zUrp-Astronomics/basilisk/9_Assets/README.md

# 9_Assets

**Date** : 2026-10-06
**Dernière révision** : 2026-10-06
**Statut** : actif — porte la fiche (`zurp.yml`) et l'affiche (`basilisk.webp`) lues par le site zUrp, et les images du README
**Référencé par** : `README.md` (images), `7_Docs/MANUEL.md` (§ Arborescence)

Les ressources pour l'extérieur, les images du `README.md` (`Basilisk-Board.png`, `Basilisk-Board-top.png`, `Basilisk-Board-bot.png`), et la vitrine lue par le site, la fiche `zurp.yml` et l'affiche `basilisk.webp`.
