zUrp-Astronomics/basilisk/0_Datasheets/README.md

Les datasheets des composants utilisés (PDF du fabricant, nom d'origine).
