zUrp-Astronomics/basilisk/1_Board/README.md

Les fichiers de fabrication de la carte, tels que les sort l'outil de CAO.
