zUrp-Astronomics/basilisk/3_3D-Models/README.md

Les fichiers prêts à imprimer, tirés de `2_Hardware/`.
