zUrp-Astronomics/basilisk/7_Docs/README.md

La documentation du projet ; le README racine reste la porte d'entrée.
