zUrp-Astronomics/basilisk/8_References/README.md

# 8_References

**Date** : 2026-10-06
**Dernière révision** : 2026-10-06
**Statut** : actif — documents de référence externes (normes, projets amont), qui restent à leurs auteurs ; la documentation d'interopérabilité des objectifs ira dans `7_Docs/`, pas ici
**Référencé par** : `7_Docs/MANUEL.md` (§ Arborescence, § Licence), `README.md` (§ Licences)

Ce que le projet consulte, pas ce qu'il produit.
