zUrp-Astronomics/basilisk/1_Board/Basilisk-v1.0_1-Schematics.png

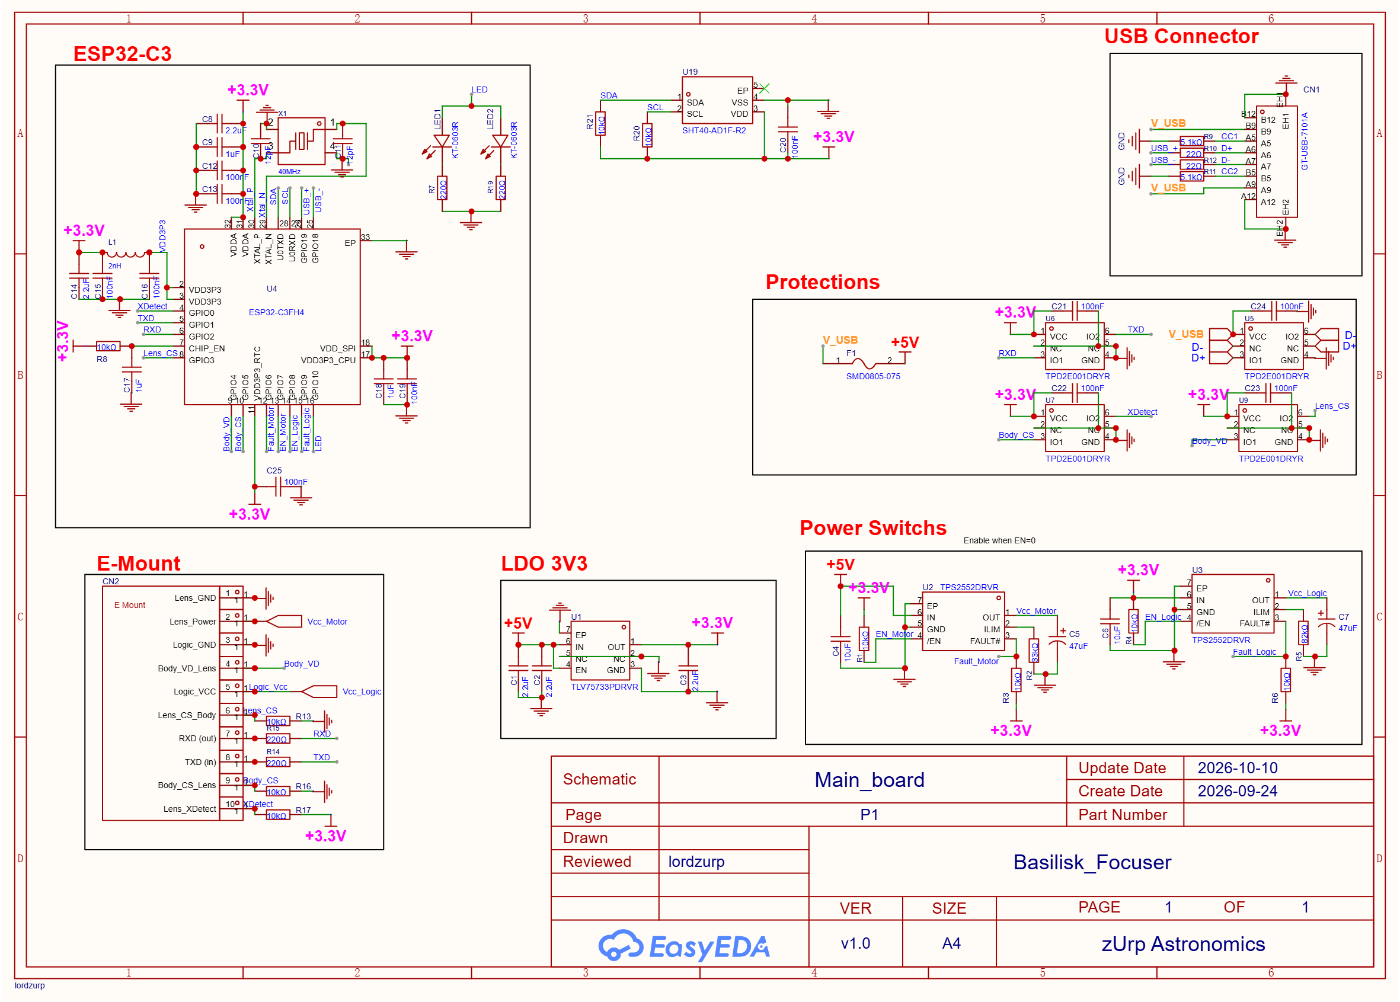
1_Board/Basilisk-v1.0_1-Schematics.png
