zUrp-Astronomics/basilisk/1_Board/Basilisk-v1.0_4-BoM.xlsx

No. | Quantity | Device | Designator | Footprint | Value | Manufacturer Part | Manufacturer | Supplier Part | Supplier | Add into BOM | Name | Category | JLCPCB Stock | JLCPCB Price | JLCPCB Part Class
1 | 5 | CL05A225MQ5NSNC | C1,C2,C3,C8,C14 | C0402 | 2.2uF | CL05A225MQ5NSNC | SAMSUNG(三星) | C12530 | LCSC | yes | 2.2uF | Capacitors:Multilayer Ceramic Capacitors MLCC - SMD/SMT | 4752852 | 0.0008 | Basic Part
2 | 2 | CL10A106KP8NNNC | C4,C6 | C0603 | 10uF | CL10A106KP8NNNC | SAMSUNG(三星) | C19702 | LCSC | yes | 10uF | Capacitors:Multilayer Ceramic Capacitors MLCC - SMD/SMT | 10417563 | 0.0046 | Basic Part
3 | 2 | T527I476M010ATE200 | C5,C7 | CAP-SMD_L3.2-W1.6 | 47uF | T527I476M010ATE200 | KEMET(基美) | C4951329 | LCSC | yes | 47uF | Capacitors:Tantalum Capacitors | 822 | 0.0738 | Extended Part
4 | 3 | CL05A105KA5NQNC | C9,C17,C18 | C0402 | 1uF | CL05A105KA5NQNC | SAMSUNG(三星) | C52923 | LCSC | yes | 1uF | Capacitors:Multilayer Ceramic Capacitors MLCC - SMD/SMT | 7267712 | 0.0014 | Basic Part
5 | 2 | 0402CG120J500NT | C10,C11 | C0402 | 12pF | 0402CG120J500NT | FH(风华) | C1547 | LCSC | yes | 12pF | Capacitors:Multilayer Ceramic Capacitors MLCC - SMD/SMT | 1830227 | 0.0006 | Basic Part
6 | 11 | CL05B104KO5NNNC | C12,C13,C15,C16,C19,C20,C21,C22,C23,C24,C25 | C0402 | 100nF | CL05B104KO5NNNC | SAMSUNG(三星) | C1525 | LCSC | yes | 100nF | Capacitors:Multilayer Ceramic Capacitors MLCC - SMD/SMT | 24104258 | 0.0007 | Basic Part
7 | 1 | GT-USB-7101A | CN1 | USB-C-SMD_GT-USB-7101A |  | GT-USB-7101A | G-Switch(品赞) | C7469647 | LCSC | yes | GT-USB-7101A | Connectors:USB Connectors | 613 | 0.0995 | Extended Part
8 | 1 | SMD0805-075 | F1 | F0805 |  | SMD0805-075 | 台湾陆海 | C70060 | LCSC | yes | SMD0805-075 | Circuit Protection:Resettable Fuses | 4382 | 0.0077 | Extended Part
9 | 1 | APGL1005-2N0SETD9 | L1 | L0402-RD | 2nH | APGL1005-2N0SETD9 | APV(爱普微) | C54951901 | LCSC | yes | 2nH | Inductors, Coils, Chokes:Inductors (SMD) | 6770 | 0.0009 | Extended Part
10 | 2 | KT-0603R | LED1,LED2 | LED-SMD_L1.6-W0.8-R-RD |  | KT-0603R | KENTO | C2286 | LCSC | yes | KT-0603R | Optoelectronics:LED Indication - Discrete | 7297573 | 0.0012 | Basic Part
11 | 10 | P70-6000045R | P1,P2,P3,P4,P5,P6,P7,P8,P9,P10 | TESTPOINT-SMD_BD1.5_P70-5000045R |  | P70-6000045R | Harwin | C7498584 | LCSC | yes | P70-6000045R | Connectors:Pogo Pin Spring Probe Connector | 5 | 0.1935 | Extended Part
12 | 10 | 0402WGF1002TCE | R1,R3,R4,R6,R8,R13,R16,R17,R20,R21 | R0402 | 10kΩ | 0402WGF1002TCE | UNI-ROYAL(厚声) | C25744 | LCSC | yes | 10kΩ | Resistors:Chip Resistor - Surface Mount | 19782266 | 0.0006 | Basic Part
13 | 1 | 0603WAF3302T5E | R2 | R0603 | 33kΩ | 0603WAF3302T5E | UNI-ROYAL(厚声) | C4216 | LCSC | yes | 33kΩ | Resistors:Chip Resistor - Surface Mount | 3802700 | 0.0004 | Basic Part
14 | 1 | 0603WAF8202T5E | R5 | R0603 | 82kΩ | 0603WAF8202T5E | UNI-ROYAL(厚声) | C23254 | LCSC | yes | 82kΩ | Resistors:Chip Resistor - Surface Mount | 1270051 | 0.0005 | Basic Part
15 | 4 | 0402WGF2200TCE | R7,R14,R15,R19 | R0402 | 220Ω | 0402WGF2200TCE | UNI-ROYAL(厚声) | C25091 | LCSC | yes | 220Ω | Resistors:Chip Resistor - Surface Mount | 1319355 | 0.0006 | Basic Part
16 | 2 | 0402WGF5101TCE | R9,R11 | R0402 | 5.1kΩ | 0402WGF5101TCE | UNI-ROYAL(厚声) | C25905 | LCSC | yes | 5.1kΩ | Resistors:Chip Resistor - Surface Mount | 5624141 | 0.0004 | Basic Part
17 | 2 | 0402WGF220JTCE | R10,R12 | R0402 | 22Ω | 0402WGF220JTCE | UNI-ROYAL(厚声) | C25092 | LCSC | yes | 22Ω | Resistors:Chip Resistor - Surface Mount | 6247885 | 0.0005 | Basic Part
18 | 1 | TLV75733PDRVR | U1 | TDFN-6_L2.0-W2.0-P0.65-TL-EP |  | TLV75733PDRVR | TI(德州仪器) | C2868428 | LCSC | yes | TLV75733PDRVR | Power Management (PMIC):Voltage Regulators - Linear, Low Drop Out (LDO) Regulators | 14899 | 0.0561 | Extended Part
19 | 2 | TPS2552DRVR | U2,U3 | WSON-6_L2.0-W2.0-P0.65-TL-EP |  | TPS2552DRVR | TI(德州仪器) | C473916 | LCSC | yes | TPS2552DRVR | Power Management (PMIC):Power Distribution Switches | 1372 | 0.0408 | Extended Part
20 | 1 | ESP32-C3FH4 | U4 | QFN-32_L5.0-W5.0-P0.50-TL-EP3.7 |  | ESP32-C3FH4 | ESPRESSIF(乐鑫) | C2858491 | LCSC | yes | ESP32-C3FH4 | Embedded Processors & Controllers:Microcontrollers (MCU/MPU/SOC) | 4904 | 0.3263 | Extended Part
21 | 4 | TPD2E001DRYR | U5,U6,U7,U9 | SON-6_L1.5-W1.0-P0.50-BL |  | TPD2E001DRYR | TI(德州仪器) | C379992 | LCSC | yes | TPD2E001DRYR | Circuit Protection:ESD and Surge Protection (TVS/ESD) | 5043 | 0.0481 | Extended Part
22 | 1 | SHT40-AD1F-R2 | U19 | DFN-4_L1.5-W1.5-P0.80-TL-EP |  | SHT40-AD1F-R2 | Sensirion(瑞士盛思锐) | C7461846 | LCSC | yes | SHT40-AD1F-R2 | Sensors:Temperature and Humidity Sensor | 299 | 0.3853 | Extended Part
23 | 1 | CN4040M00010T8188016 | X1 | CRYSTAL-SMD_4P-L2.0-W1.6-BL_HUAXIN_CN4 | 40MHz | CN4040M00010T8188016 | JWT(晶威特) | C2933016 | LCSC | yes | 40MHz | Crystals, Oscillators, Resonators:Crystals | 1349 | 0.0228 | Extended Part
