zUrp-Astronomics/basilisk/2_Hardware/Basilisk_v1.0b_enclosure-top.step

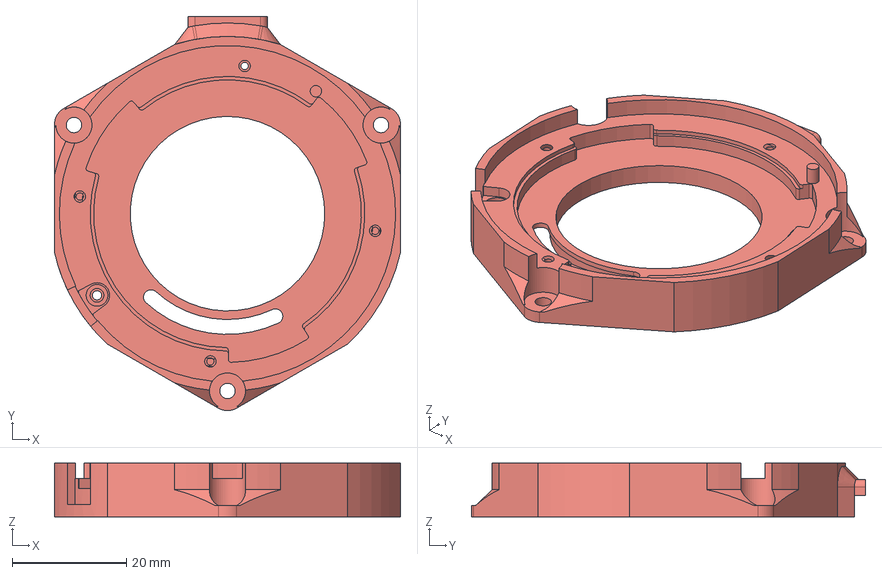
[picture p6: CAD file, 2026-10-10]
2_Hardware/Basilisk_v1.0b_enclosure-top.step
60.5 x 68.9 x 9.40 mm
