zUrp-Astronomics/basilisk/3_3D-Models/Basilisk_v1.0b_enclosure.3mf

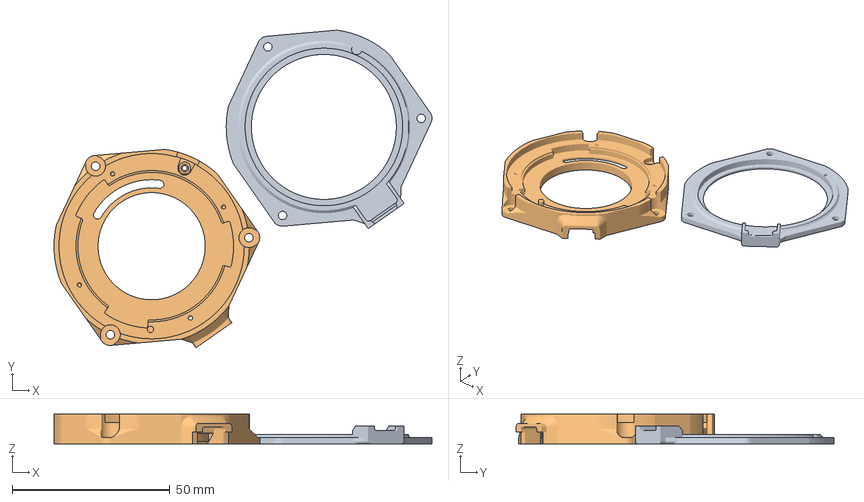
[picture p7: CAD file, 2026-10-10]
3_3D-Models/Basilisk_v1.0b_enclosure.3mf
120.0 x 100.9 x 9.40 mm
48mm (1)
Corps129
