zUrp-Astronomics/basilisk/2_Hardware/Basilisk_v1.0b_enclosure-bot.step

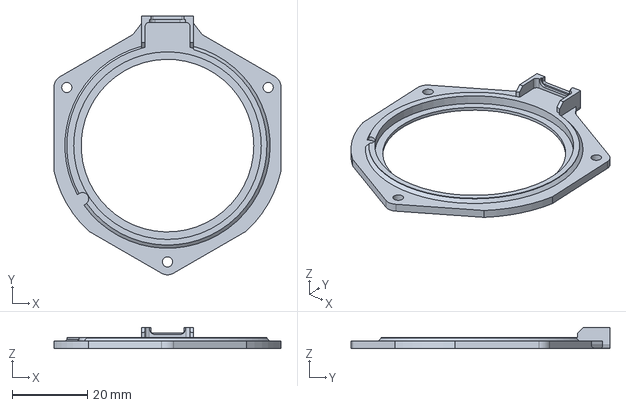
[picture p8: CAD file, 2026-10-10]
2_Hardware/Basilisk_v1.0b_enclosure-bot.step
60.5 x 68.9 x 5.73 mm
