zUrp-Astronomics/basilisk/1_Board/Basilisk-v1.0_1-Schematics.pdf

# USB Connector ESP32-C3

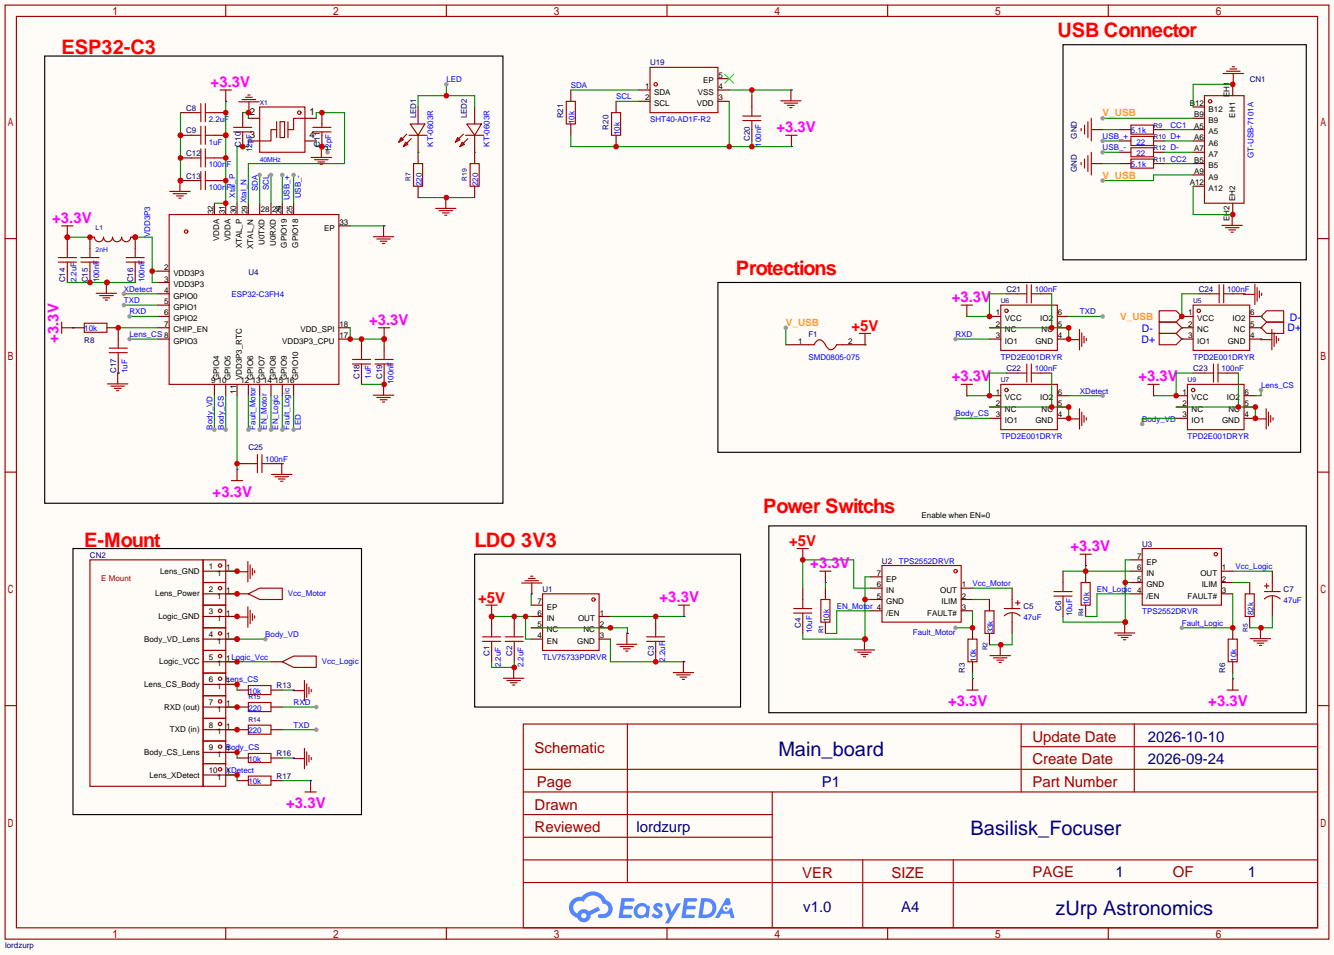
[picture p9: page 1]
