zUrp-Astronomics/basilisk/(commit log)

2026-10-10 v0.9 — version de test sur XIAO-ESP32-S3
    Premier jalon publie depuis la forge de la fleet.
    LCARS-Jalon-Source: 2405044a7407458aa5e36e27bb2eeae6d7b022e2
    [Basilisk-v1.0_4-BoM.xlsx, Basilisk-v1.0_5-PnP.xlsx, Basilisk_v1.0b_enclosure-bot.step, Basilisk_v1.0b_enclosure-top.step, Basilisk_v1.0b_enclosure.3mf, sy135-2026-09-20-dump05.txt]
2026-10-11 v0.9.1 — vitrine et licences à la norme de l'org, cible ESP32-C3 ajoutée (non validée sur carte)
    - CLAUDE.md à la norme Anthropic : carte de l'environnement, aucune règle perdue (PR interne 586)
    - Vitrine : tagline harmonisée, slogan du README sans point (PR interne 587)
    - Soft v1.0 : cible ESP32-C3 et table de broches de la carte v1.0 (PR interne 580)
    - Vitrine au cordeau — README, 9_Assets, licences et workflow à la norme de l'org (PR interne 579)
    LCARS-Jalon-Source: 9bdb317e5f4788256b9393003ee1e0d0b62a3911
2026-10-16 v0.9.2 — first beta
    - Boîtier v1.0b du 2026-10-15 : CAO, fichiers d'impression et image du README (PR interne 621)
    - Publication du firmware à la norme de l'org : tag semver, release par Actions, ESP Web Tools (PR interne 618)
    - Publication GitHub du firmware : build à chaque push, release outillée pour le flash en un clic (PR interne 613)
    - Une seule cible, la carte v1.0 : la XIAO ESP32-S3 retirée, versions ramenées à 0.9 (PR interne 611)
    - Livraison du firmware : binaire nommé basilisk_FW, image unique et scripts de flash (PR interne 609)
    - Fourche INDI (ext=1) : bornes de l'objectif appliquées depuis r, rendues par Calibrate (PR interne 601)
    - SHT40 : la carte v1.0 lit tempéra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
2026-10-16 v0.9.3 — procédure de flash
    - Procédure de flash de Basilisk dans le dépôt, et la release qui la sert (PR interne 627)
    LCARS-Jalon-Source: 44bad8de005b799d108464a7c24b302157597109
2026-10-16 v0.9.4 — banc web
    - Page de banc : interface FR/EN avec bascule en haut de page (PR interne 637)
    - Release : joindre la page de banc (basilisk_<tag>_bench.html) (PR interne 636)
    - README § Flash : le flash en un clic depuis la page produit (PR interne 631)
    - firmware.yml : actions GitHub sur Node 24 (PR interne 629)
    LCARS-Jalon-Source: 08107b1a317d8f6bb386a7331212c033ed01f753
2026-10-20 v1.0.0 — v1.0
    - README racine v1.0 : présentation du projet et du dépôt, FR puis EN (PR interne 664)
    - Manuel de la page produit : corrections de forme de la relecture du site (PR interne 663)
    - Manuel de la page produit : 9_Assets/manual/ (overview, assembly, setup, usage) en anglais (PR interne 660)
    - CLAUDE.md § Conventions : le README et le manuel de 9_Assets sont au projet (PR interne 658)
    - Versions de la release v1.0 : firmware en 1.3, driver INDI en 1.2 (PR interne 657)
    - Matériel v1.0 : boîtier final, BoM et informations brutes dans 2_Hardware et 3_3D-Models (PR interne 654)
    - Driver INDI : pinefeat_cef amont + correctifs (PR 1) + extension Basilisk (PR 2) (PR interne 646)
    -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
2026-10-27 Mise à jour du 2026-10-27
    - Docs : installer la version de Codex, à l'essai (PR interne 812)
    - Fuzzing F4 : libFuzzer sur les cibles d'octets, sur le runner (PR interne 809)
    - Fuzzing F3 : l'hôte fou, des lignes USB arbitraires dans les scénarios de l'objectif fou (PR interne 802)
    - Fuzzing F2 : l'objectif fou, la SESSION face à un objectif imprévisible (PR interne 800)
    - Fuzzing F1 : le banc gcc et les cibles qu'on appelle seules (PR interne 798)
    - Docs : le rapport de confiance du firmware (FR et EN) et sa version courte au README (PR interne 796)
    - Sonde test-relevance : rendre un verdict dans son budget (plus de mort au plafond de 20 min) (PR interne 793)
    - Test de la page : plus a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
